ARTS-Laboratory/Ship-Structure-and-Fatigue-Environment-Ship-SAFE-testbed/README.md

# Ship Structure and Fatigue Environment (Ship SAFE) testbed
A tested for integrated ship structural and fatigue testing

<p align="center">
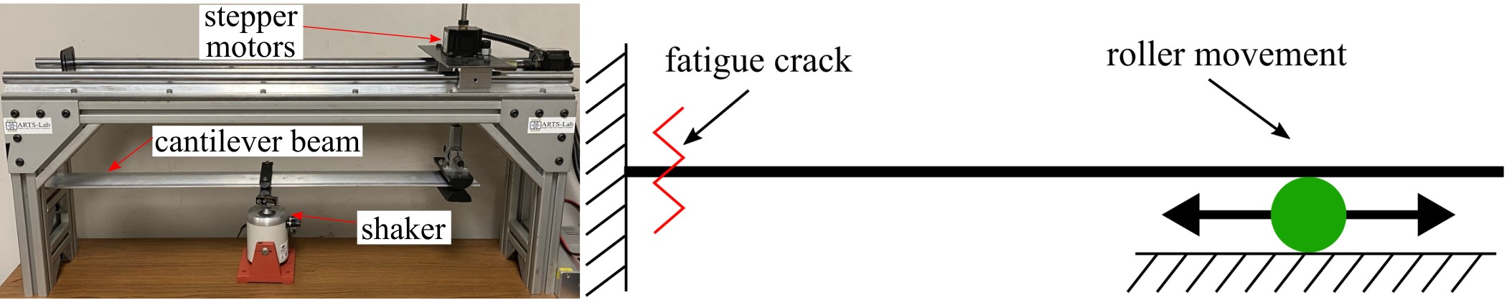
[picture p1: media/testbed.jpg]

</p>
<p align="center">
The Ship Structure and Fatigue Environment (Ship SAFE) testbed develoepd at the UofSC
</p>

## [Testbed](testbed)
CAD and FEA models of the testbed.

## Licensing and Citation

[][cc-by-sa]

This work is licensed under a
[Creative Commons Attribution-ShareAlike 4.0 International License][cc-by-sa].

[cc-by-sa]: http://creativecommons.org/licenses/by-sa/4.0/
[cc-by-sa-image]: https://licensebuttons.net/l/by-sa/4.0/88x31.png
[cc-by-sa-shield]: https://img.shields.io/badge/License-CC%20BY--SA%204.0-lightgrey.svg
