ARTS-Laboratory/Ship-Structure-and-Fatigue-Environment-Ship-SAFE-testbed/testbed/CAD/16_mm_Rail/16 mm SUPPORT RAIL v3.step

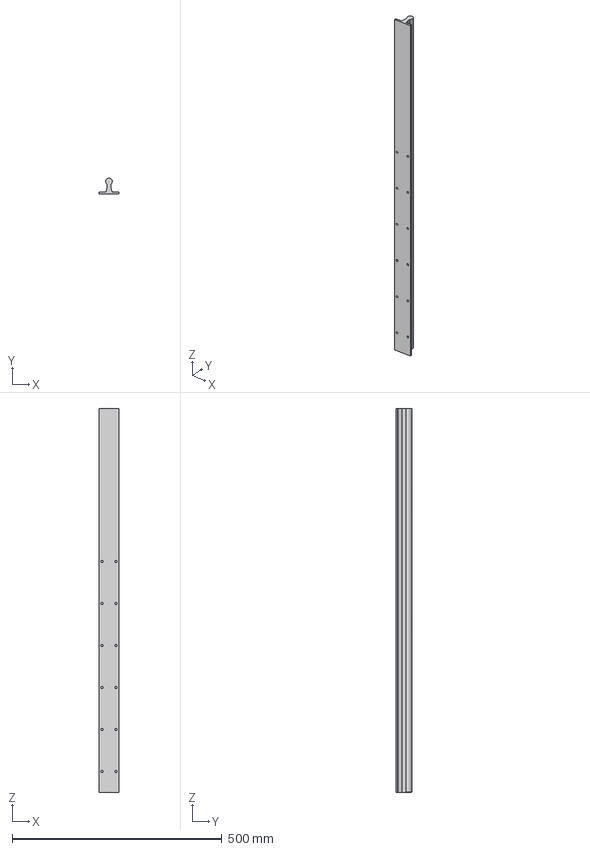
[picture p2: CAD file, 2022-03-26]
testbed/CAD/16_mm_Rail/16 mm SUPPORT RAIL v3.step
48.0 x 38.0 x 914.4 mm
