ARTS-Laboratory/Ship-Structure-and-Fatigue-Environment-Ship-SAFE-testbed/testbed/CAD/16_mm_Rail_Plate/16 mm Rail Plate v3.step

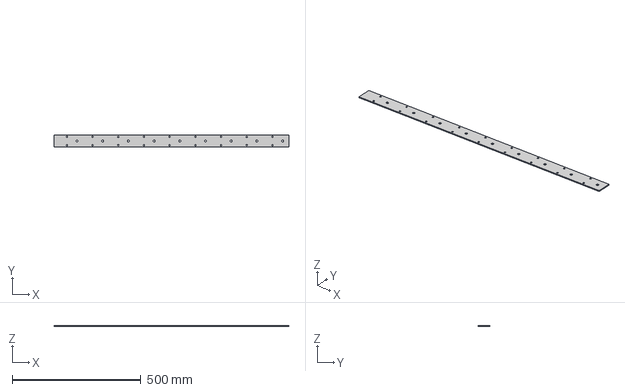
[picture p3: CAD file, 2022-03-26]
testbed/CAD/16_mm_Rail_Plate/16 mm Rail Plate v3.step
914.4 x 48.0 x 3.17 mm
