ARTS-Laboratory/Ship-Structure-and-Fatigue-Environment-Ship-SAFE-testbed/testbed/CAD/16_mm_Rail_Support/16 mm rail support TBR16UU v1.step

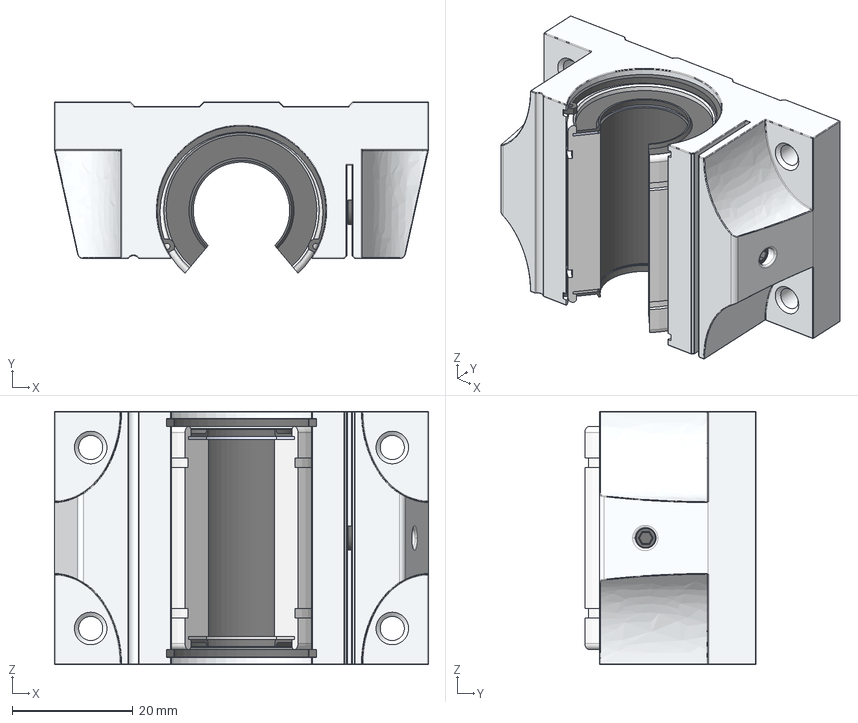
[picture p4: CAD file, 2022-03-26]
testbed/CAD/16_mm_Rail_Support/16 mm rail support TBR16UU v1.step
62.0 x 28.4 x 42.0 mm
TBR16UU
LM16UUOP
