ARTS-Laboratory/Ship-Structure-and-Fatigue-Environment-Ship-SAFE-testbed/testbed/CAD/40X40_12_in/40mm X 40mm 12 in v1.step

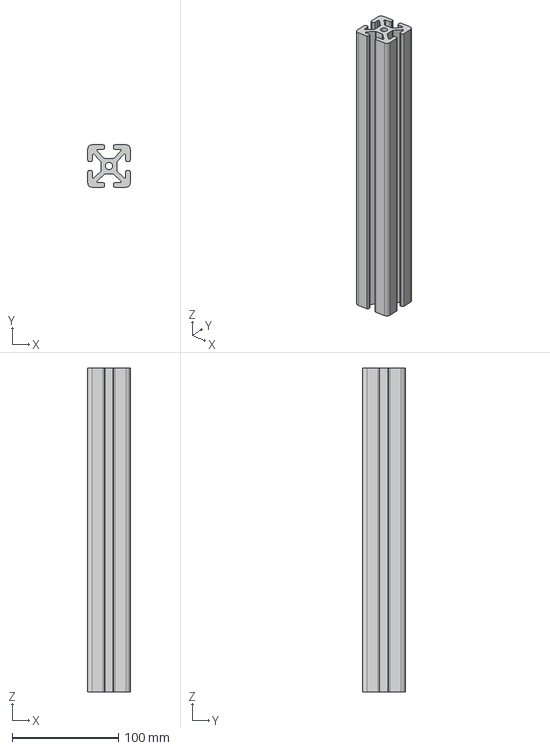
[picture p5: CAD file, 2022-03-26]
testbed/CAD/40X40_12_in/40mm X 40mm 12 in v1.step
40.0 x 40.0 x 304.8 mm
