ARTS-Laboratory/Ship-Structure-and-Fatigue-Environment-Ship-SAFE-testbed/testbed/CAD/40X40_3_ft/40mm X 40mm 3ft v2.step

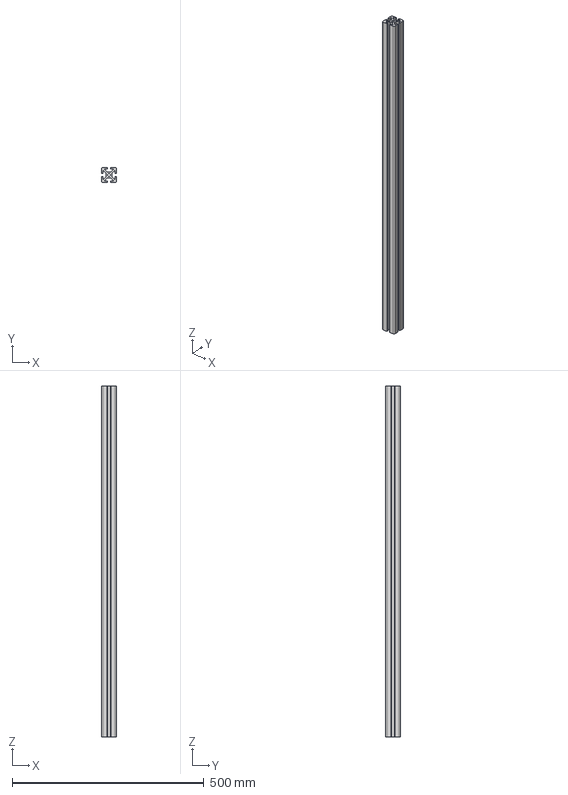
[picture p6: CAD file, 2022-03-26]
testbed/CAD/40X40_3_ft/40mm X 40mm 3ft v2.step
40.0 x 40.0 x 914.4 mm
