ARTS-Laboratory/Ship-Structure-and-Fatigue-Environment-Ship-SAFE-testbed/testbed/CAD/40X40_45_Degree/40mm X 40mm 45 Degree v1.step

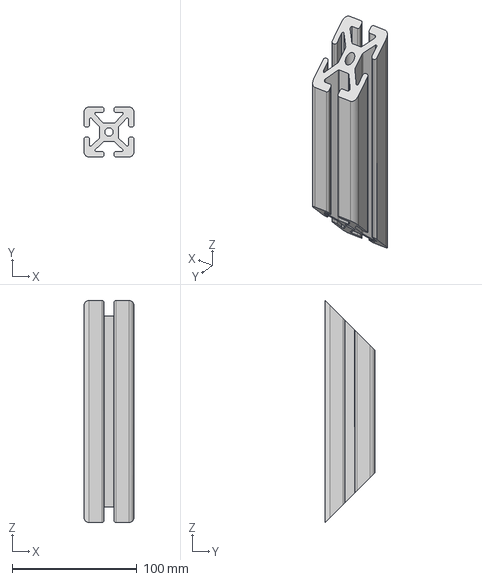
[picture p7: CAD file, 2022-03-26]
testbed/CAD/40X40_45_Degree/40mm X 40mm 45 Degree v1.step
40.0 x 40.0 x 177.8 mm
