ARTS-Laboratory/Ship-Structure-and-Fatigue-Environment-Ship-SAFE-testbed/testbed/CAD/40X40_97.8_mm/40mm X 40mm 97.8 mm v1.step

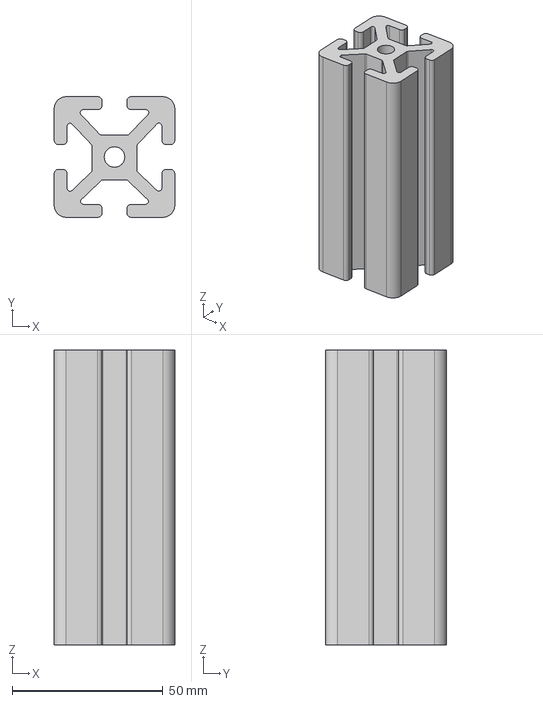
[picture p8: CAD file, 2022-03-26]
testbed/CAD/40X40_97.8_mm/40mm X 40mm 97.8 mm v1.step
40.0 x 40.0 x 97.8 mm
