ARTS-Laboratory/Ship-Structure-and-Fatigue-Environment-Ship-SAFE-testbed/testbed/CAD/Boat_Hull/Boat Hull v4.step

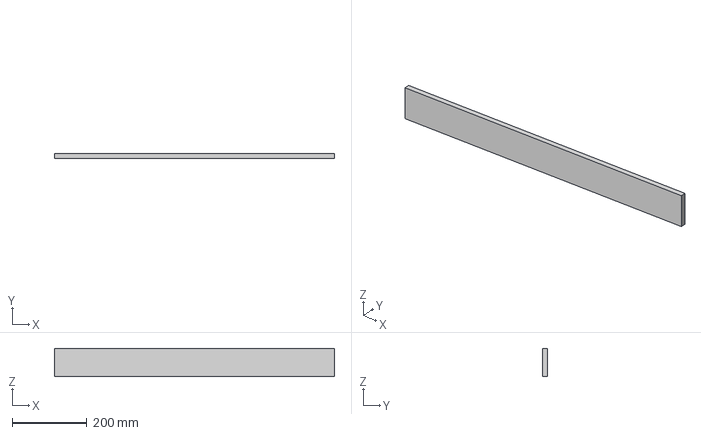
[picture p10: CAD file, 2022-03-26]
testbed/CAD/Boat_Hull/Boat Hull v4.step
750.0 x 12.7 x 76.2 mm
