ARTS-Laboratory/Ship-Structure-and-Fatigue-Environment-Ship-SAFE-testbed/testbed/CAD/Metric_Ball_Joint/METRIC BALL JOINT v1.step

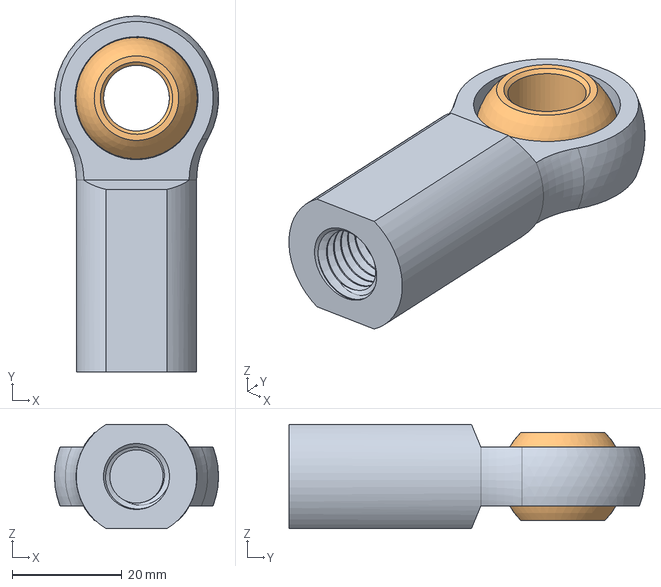
[picture p11: CAD file, 2022-03-26]
testbed/CAD/Metric_Ball_Joint/METRIC BALL JOINT v1.step
30.0 x 65.0 x 19.0 mm
