ARTS-Laboratory/Ship-Structure-and-Fatigue-Environment-Ship-SAFE-testbed/testbed/CAD/Shaker/Shaker v1.step

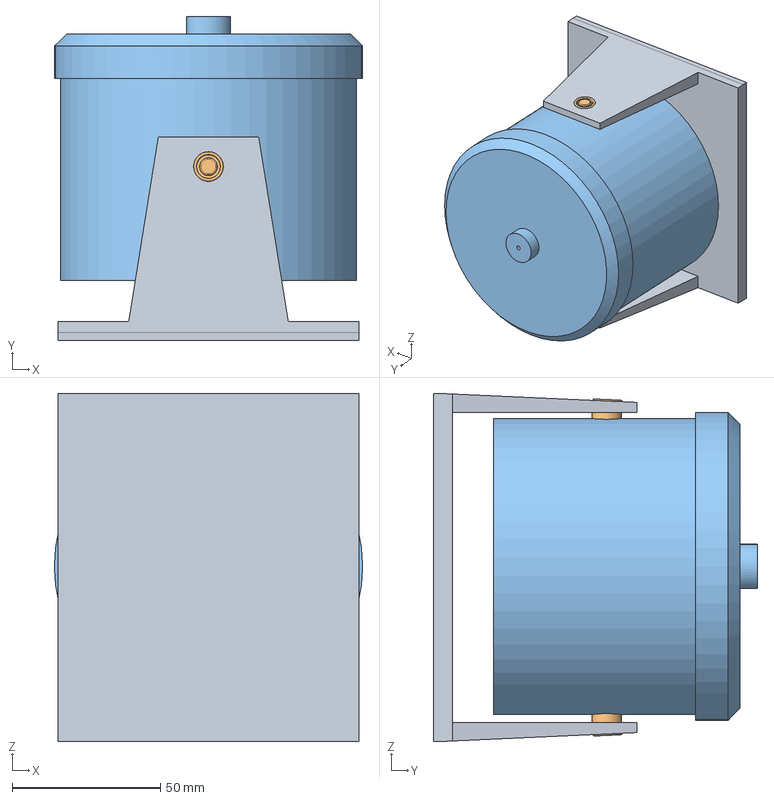
[picture p12: CAD file, 2022-03-26]
testbed/CAD/Shaker/Shaker v1.step
104.0 x 109.3 x 117.4 mm
Actual Shaker Stand
Shacker Pin Small x 2
