ARTS-Laboratory/Ship-Structure-and-Fatigue-Environment-Ship-SAFE-testbed/testbed/CAD/Shaker_Fixture/Shaker Fixture v1.step

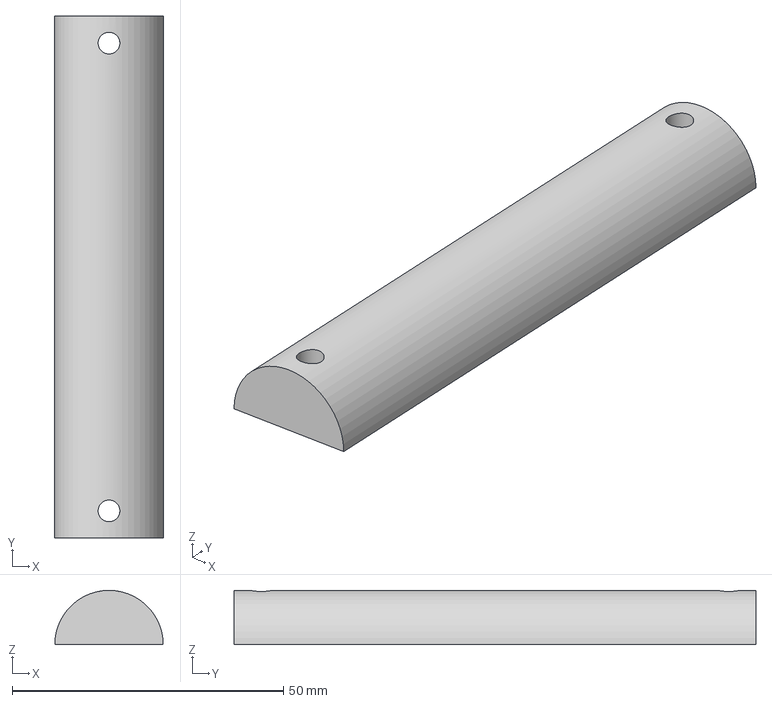
[picture p13: CAD file, 2022-03-26]
testbed/CAD/Shaker_Fixture/Shaker Fixture v1.step
20.0 x 96.2 x 10.0 mm
