ARTS-Laboratory/Ship-Structure-and-Fatigue-Environment-Ship-SAFE-testbed/testbed/CAD/SK_12_mm/SK 12mm v1.step

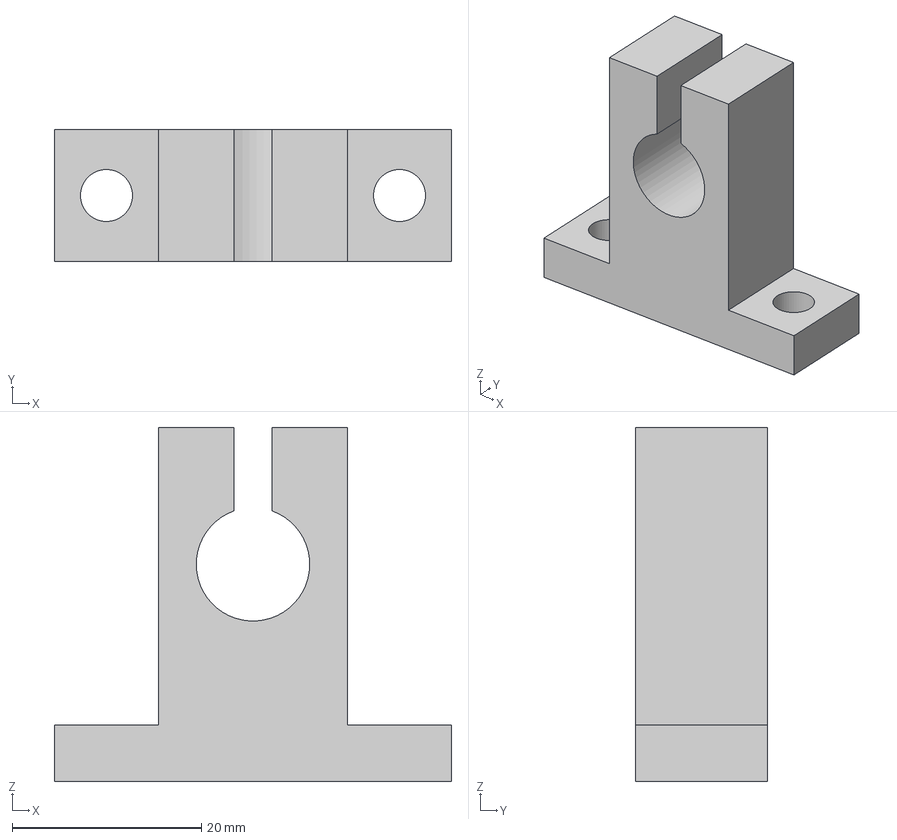
[picture p14: CAD file, 2022-03-26]
testbed/CAD/SK_12_mm/SK 12mm v1.step
42.0 x 14.0 x 37.5 mm
