ARTS-Laboratory/Ship-Structure-and-Fatigue-Environment-Ship-SAFE-testbed/testbed/CAD/Stepper_Fixture/Stepper Fixture v1.step

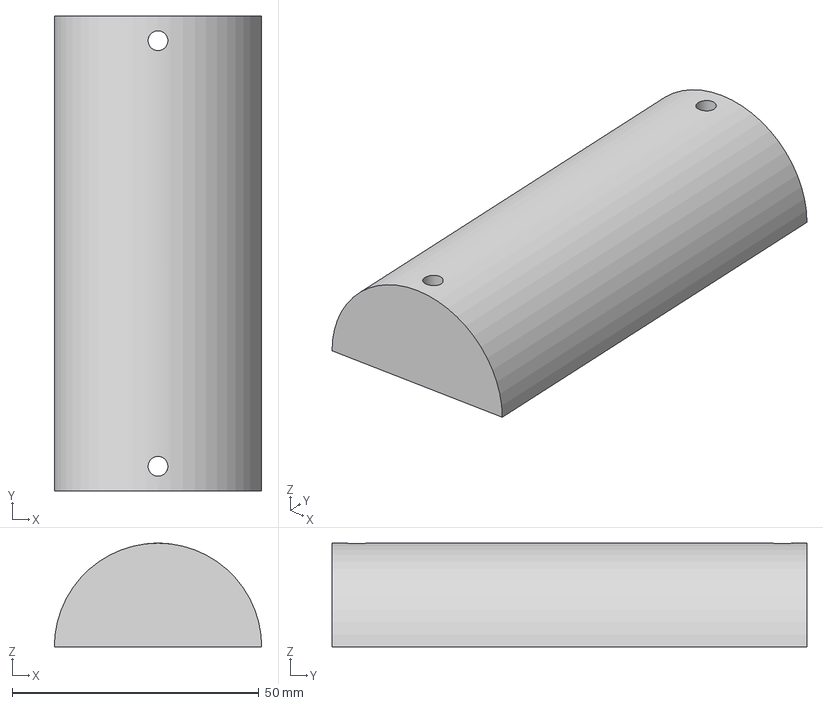
[picture p15: CAD file, 2022-03-26]
testbed/CAD/Stepper_Fixture/Stepper Fixture v1.step
42.0 x 96.2 x 21.0 mm
