ARTS-Laboratory/Ship-Structure-and-Fatigue-Environment-Ship-SAFE-testbed/testbed/CAD/Stepper_Through_Hole/Stepper Motor Through Hole v1.step

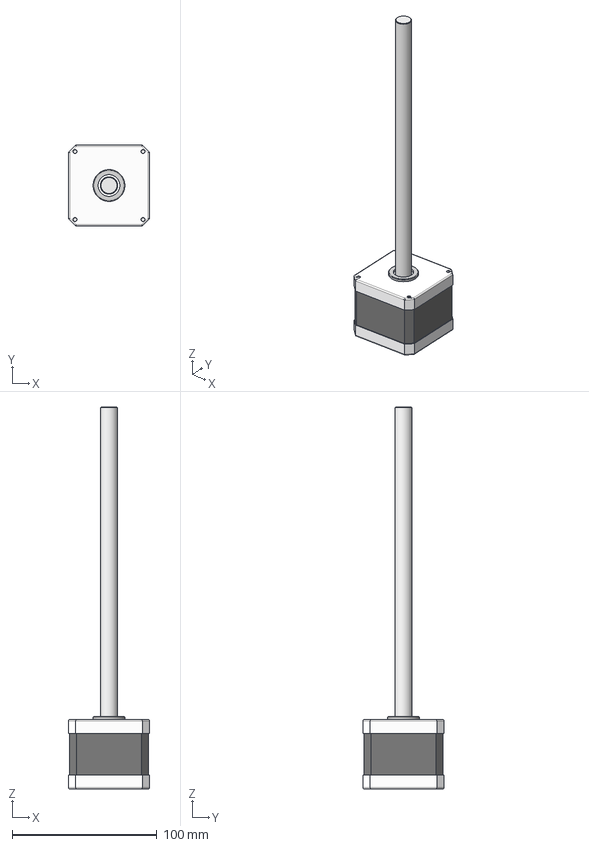
[picture p17: CAD file, 2022-03-26]
testbed/CAD/Stepper_Through_Hole/Stepper Motor Through Hole v1.step
56.0 x 56.0 x 263.9 mm
