ARTS-Laboratory/Ship-Structure-and-Fatigue-Environment-Ship-SAFE-testbed/testbed/CAD/Stepper_Through_Hole_Offset/Stepper Motor Through Hole offset v1.step

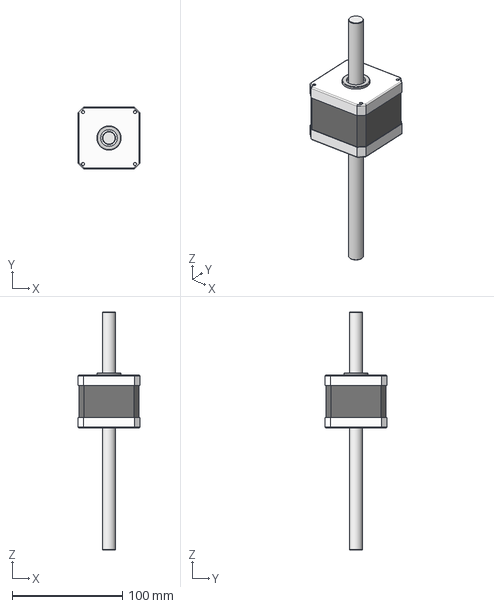
[picture p18: CAD file, 2022-03-26]
testbed/CAD/Stepper_Through_Hole_Offset/Stepper Motor Through Hole offset v1.step
56.0 x 56.0 x 215.9 mm
