ARTS-Laboratory/Ship-Structure-and-Fatigue-Environment-Ship-SAFE-testbed/testbed/CAD/Eye_Bolt/Eye Bolt v1.step

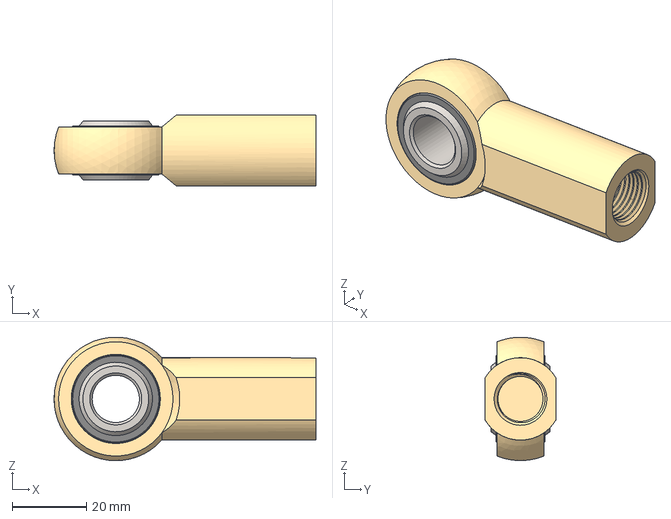
[picture p19: CAD file, 2022-03-26]
testbed/CAD/Eye_Bolt/Eye Bolt v1.step
70.6 x 19.0 x 33.3 mm
