ARTS-Laboratory/Ship-Structure-and-Fatigue-Environment-Ship-SAFE-testbed/(list of files, cad)

Other CAD files:
testbed/CAD/16_mm_Rail/16 mm SUPPORT RAIL v3.3mf
testbed/CAD/16_mm_Rail/16 mm SUPPORT RAIL v3.dwg
testbed/CAD/16_mm_Rail/16 mm SUPPORT RAIL v3.dxf
testbed/CAD/16_mm_Rail/16 mm SUPPORT RAIL v3.f3d
testbed/CAD/16_mm_Rail/16 mm SUPPORT RAIL v3.iges
testbed/CAD/16_mm_Rail/16 mm SUPPORT RAIL v3.ipt
testbed/CAD/16_mm_Rail/16 mm SUPPORT RAIL v3.obj
testbed/CAD/16_mm_Rail/16 mm SUPPORT RAIL v3.skp
testbed/CAD/16_mm_Rail/16 mm SUPPORT RAIL v3.stl
testbed/CAD/16_mm_Rail_Plate/16 mm Rail Plate v3.3mf
testbed/CAD/16_mm_Rail_Plate/16 mm Rail Plate v3.dwg
testbed/CAD/16_mm_Rail_Plate/16 mm Rail Plate v3.dxf
testbed/CAD/16_mm_Rail_Plate/16 mm Rail Plate v3.f3d
testbed/CAD/16_mm_Rail_Plate/16 mm Rail Plate v3.iges
testbed/CAD/16_mm_Rail_Plate/16 mm Rail Plate v3.ipt
testbed/CAD/16_mm_Rail_Plate/16 mm Rail Plate v3.obj
testbed/CAD/16_mm_Rail_Plate/16 mm Rail Plate v3.skp
testbed/CAD/16_mm_Rail_Plate/16 mm Rail Plate v3.stl
testbed/CAD/16_mm_Rail_Support/16 mm rail support TBR16UU v1.3mf
testbed/CAD/16_mm_Rail_Support/16 mm rail support TBR16UU v1.dwg
testbed/CAD/16_mm_Rail_Support/16 mm rail support TBR16UU v1.dxf
testbed/CAD/16_mm_Rail_Support/16 mm rail support TBR16UU v1.f3d
testbed/CAD/16_mm_Rail_Support/16 mm rail support TBR16UU v1.iges
testbed/CAD/16_mm_Rail_Support/16 mm rail support TBR16UU v1.obj
testbed/CAD/16_mm_Rail_Support/16 mm rail support TBR16UU v1.skp
testbed/CAD/16_mm_Rail_Support/16 mm rail support TBR16UU v1.stl
testbed/CAD/40X40_12_in/40mm X 40mm 12 in v1.3mf
testbed/CAD/40X40_12_in/40mm X 40mm 12 in v1.dwg
testbed/CAD/40X40_12_in/40mm X 40mm 12 in v1.dxf
testbed/CAD/40X40_12_in/40mm X 40mm 12 in v1.f3d
testbed/CAD/40X40_12_in/40mm X 40mm 12 in v1.iges
testbed/CAD/40X40_12_in/40mm X 40mm 12 in v1.ipt
testbed/CAD/40X40_12_in/40mm X 40mm 12 in v1.obj
testbed/CAD/40X40_12_in/40mm X 40mm 12 in v1.skp
testbed/CAD/40X40_12_in/40mm X 40mm 12 in v1.stl
testbed/CAD/40X40_3_ft/40mm X 40mm 3ft v2.3mf
testbed/CAD/40X40_3_ft/40mm X 40mm 3ft v2.dwg
testbed/CAD/40X40_3_ft/40mm X 40mm 3ft v2.dxf
testbed/CAD/40X40_3_ft/40mm X 40mm 3ft v2.f3d
testbed/CAD/40X40_3_ft/40mm X 40mm 3ft v2.iges
testbed/CAD/40X40_3_ft/40mm X 40mm 3ft v2.ipt
testbed/CAD/40X40_3_ft/40mm X 40mm 3ft v2.obj
testbed/CAD/40X40_3_ft/40mm X 40mm 3ft v2.skp
testbed/CAD/40X40_3_ft/40mm X 40mm 3ft v2.stl
testbed/CAD/40X40_45_Degree/40mm X 40mm 45 Degree v1.3mf
testbed/CAD/40X40_45_Degree/40mm X 40mm 45 Degree v1.dwg
testbed/CAD/40X40_45_Degree/40mm X 40mm 45 Degree v1.dxf
testbed/CAD/40X40_45_Degree/40mm X 40mm 45 Degree v1.f3d
testbed/CAD/40X40_45_Degree/40mm X 40mm 45 Degree v1.iges
testbed/CAD/40X40_45_Degree/40mm X 40mm 45 Degree v1.ipt
testbed/CAD/40X40_45_Degree/40mm X 40mm 45 Degree v1.obj
testbed/CAD/40X40_45_Degree/40mm X 40mm 45 Degree v1.skp
testbed/CAD/40X40_45_Degree/40mm X 40mm 45 Degree v1.stl
testbed/CAD/40X40_97.8_mm/40mm X 40mm 97.8 mm v1.3mf
testbed/CAD/40X40_97.8_mm/40mm X 40mm 97.8 mm v1.dwg
testbed/CAD/40X40_97.8_mm/40mm X 40mm 97.8 mm v1.dxf
testbed/CAD/40X40_97.8_mm/40mm X 40mm 97.8 mm v1.f3d
testbed/CAD/40X40_97.8_mm/40mm X 40mm 97.8 mm v1.iges
testbed/CAD/40X40_97.8_mm/40mm X 40mm 97.8 mm v1.ipt
testbed/CAD/40X40_97.8_mm/40mm X 40mm 97.8 mm v1.obj
testbed/CAD/40X40_97.8_mm/40mm X 40mm 97.8 mm v1.skp
testbed/CAD/40X40_97.8_mm/40mm X 40mm 97.8 mm v1.stl
testbed/CAD/Assembled_Testbed/Navy 40 X 40 Stepper Box v8.f3z
testbed/CAD/Assembled_Testbed/Navy 40 X 40 Stepper Box v9.dwg
testbed/CAD/Boat_Hull/Boat Hull v4.3mf
testbed/CAD/Boat_Hull/Boat Hull v4.dwg
testbed/CAD/Boat_Hull/Boat Hull v4.dxf
testbed/CAD/Boat_Hull/Boat Hull v4.f3d
testbed/CAD/Boat_Hull/Boat Hull v4.iges
testbed/CAD/Boat_Hull/Boat Hull v4.ipt
testbed/CAD/Boat_Hull/Boat Hull v4.obj
testbed/CAD/Boat_Hull/Boat Hull v4.skp
testbed/CAD/Boat_Hull/Boat Hull v4.stl
testbed/CAD/Eye_Bolt/Eye Bolt v1.3mf
testbed/CAD/Eye_Bolt/Eye Bolt v1.dwg
testbed/CAD/Eye_Bolt/Eye Bolt v1.dxf
testbed/CAD/Eye_Bolt/Eye Bolt v1.f3d
testbed/CAD/Eye_Bolt/Eye Bolt v1.iges
testbed/CAD/Eye_Bolt/Eye Bolt v1.ipt
testbed/CAD/Eye_Bolt/Eye Bolt v1.obj
testbed/CAD/Eye_Bolt/Eye Bolt v1.skp
testbed/CAD/Eye_Bolt/Eye Bolt v1.stl
testbed/CAD/Eye_Bolt_Screw/Eye Bolt Screw v1.3mf
testbed/CAD/Eye_Bolt_Screw/Eye Bolt Screw v1.dwg
testbed/CAD/Eye_Bolt_Screw/Eye Bolt Screw v1.f3d
testbed/CAD/Eye_Bolt_Screw/Eye Bolt Screw v1.ipt
testbed/CAD/Eye_Bolt_Screw/Eye Bolt Screw v1.obj
testbed/CAD/Eye_Bolt_Screw/Eye Bolt Screw v1.skp
testbed/CAD/Eye_Bolt_Screw/Eye Bolt Screw v1.stl
testbed/CAD/Metric_Ball_Joint/METRIC BALL JOINT v1.3mf
testbed/CAD/Metric_Ball_Joint/METRIC BALL JOINT v1.dwg
testbed/CAD/Metric_Ball_Joint/METRIC BALL JOINT v1.dxf
testbed/CAD/Metric_Ball_Joint/METRIC BALL JOINT v1.f3d
testbed/CAD/Metric_Ball_Joint/METRIC BALL JOINT v1.iges
testbed/CAD/Metric_Ball_Joint/METRIC BALL JOINT v1.ipt
testbed/CAD/Metric_Ball_Joint/METRIC BALL JOINT v1.obj
testbed/CAD/Metric_Ball_Joint/METRIC BALL JOINT v1.skp
testbed/CAD/Metric_Ball_Joint/METRIC BALL JOINT v1.stl
testbed/CAD/SK_12_mm/SK 12mm v1.3mf
testbed/CAD/SK_12_mm/SK 12mm v1.dwg
testbed/CAD/SK_12_mm/SK 12mm v1.dxf
testbed/CAD/SK_12_mm/SK 12mm v1.f3d
testbed/CAD/SK_12_mm/SK 12mm v1.iges
testbed/CAD/SK_12_mm/SK 12mm v1.ipt
testbed/CAD/SK_12_mm/SK 12mm v1.obj
testbed/CAD/SK_12_mm/SK 12mm v1.skp
testbed/CAD/SK_12_mm/SK 12mm v1.stl
testbed/CAD/Shaker/Shaker v1.3mf
testbed/CAD/Shaker/Shaker v1.dwg
testbed/CAD/Shaker/Shaker v1.dxf
testbed/CAD/Shaker/Shaker v1.f3z
testbed/CAD/Shaker/Shaker v1.iges
testbed/CAD/Shaker/Shaker v1.obj
testbed/CAD/Shaker/Shaker v1.skp
testbed/CAD/Shaker/Shaker v1.stl
testbed/CAD/Shaker_Fixture/Shaker Fixture v1.3mf
testbed/CAD/Shaker_Fixture/Shaker Fixture v1.dwg
testbed/CAD/Shaker_Fixture/Shaker Fixture v1.dxf
testbed/CAD/Shaker_Fixture/Shaker Fixture v1.f3d
testbed/CAD/Shaker_Fixture/Shaker Fixture v1.iges
testbed/CAD/Shaker_Fixture/Shaker Fixture v1.ipt
testbed/CAD/Shaker_Fixture/Shaker Fixture v1.obj
testbed/CAD/Shaker_Fixture/Shaker Fixture v1.skp
testbed/CAD/Shaker_Fixture/Shaker Fixture v1.stl
testbed/CAD/Stepper_Fixture/Stepper Fixture v1.3mf
testbed/CAD/Stepper_Fixture/Stepper Fixture v1.dwg
testbed/CAD/Stepper_Fixture/Stepper Fixture v1.dxf
testbed/CAD/Stepper_Fixture/Stepper Fixture v1.f3d
testbed/CAD/Stepper_Fixture/Stepper Fixture v1.iges
testbed/CAD/Stepper_Fixture/Stepper Fixture v1.ipt
testbed/CAD/Stepper_Fixture/Stepper Fixture v1.obj
testbed/CAD/Stepper_Fixture/Stepper Fixture v1.skp
testbed/CAD/Stepper_Fixture/Stepper Fixture v1.stl
testbed/CAD/Stepper_Plate/Stepper Plate v6.3mf
testbed/CAD/Stepper_Plate/Stepper Plate v6.dwg
testbed/CAD/Stepper_Plate/Stepper Plate v6.dxf
testbed/CAD/Stepper_Plate/Stepper Plate v6.f3d
testbed/CAD/Stepper_Plate/Stepper Plate v6.iges
testbed/CAD/Stepper_Plate/Stepper Plate v6.ipt
testbed/CAD/Stepper_Plate/Stepper Plate v6.obj
testbed/CAD/Stepper_Plate/Stepper Plate v6.skp
testbed/CAD/Stepper_Plate/Stepper Plate v6.stl
testbed/CAD/Stepper_Through_Hole/Stepper Motor Through Hole v1.3mf
testbed/CAD/Stepper_Through_Hole/Stepper Motor Through Hole v1.dwg
testbed/CAD/Stepper_Through_Hole/Stepper Motor Through Hole v1.dxf
testbed/CAD/Stepper_Through_Hole/Stepper Motor Through Hole v1.f3d
testbed/CAD/Stepper_Through_Hole/Stepper Motor Through Hole v1.iges
testbed/CAD/Stepper_Through_Hole/Stepper Motor Through Hole v1.ipt
testbed/CAD/Stepper_Through_Hole/Stepper Motor Through Hole v1.obj
testbed/CAD/Stepper_Through_Hole/Stepper Motor Through Hole v1.skp
testbed/CAD/Stepper_Through_Hole/Stepper Motor Through Hole v1.stl
testbed/CAD/Stepper_Through_Hole_Offset/Stepper Motor Through Hole offset v1.3mf
testbed/CAD/Stepper_Through_Hole_Offset/Stepper Motor Through Hole offset v1.dwg
testbed/CAD/Stepper_Through_Hole_Offset/Stepper Motor Through Hole offset v1.dxf
testbed/CAD/Stepper_Through_Hole_Offset/Stepper Motor Through Hole offset v1.f3d
testbed/CAD/Stepper_Through_Hole_Offset/Stepper Motor Through Hole offset v1.iges
testbed/CAD/Stepper_Through_Hole_Offset/Stepper Motor Through Hole offset v1.ipt
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
