ARTS-Laboratory/Ship-Structure-and-Fatigue-Environment-Ship-SAFE-testbed/testbed/README.md

# Testbed
A tested for integrated ship structural and fatigue testing

## [CAD](CAD)
1. CAD files for the test bed.
