ARTS-Laboratory/Ship-Structure-and-Fatigue-Environment-Ship-SAFE-testbed/testbed/FEA/Modes/Mode_1/Mode_1.png

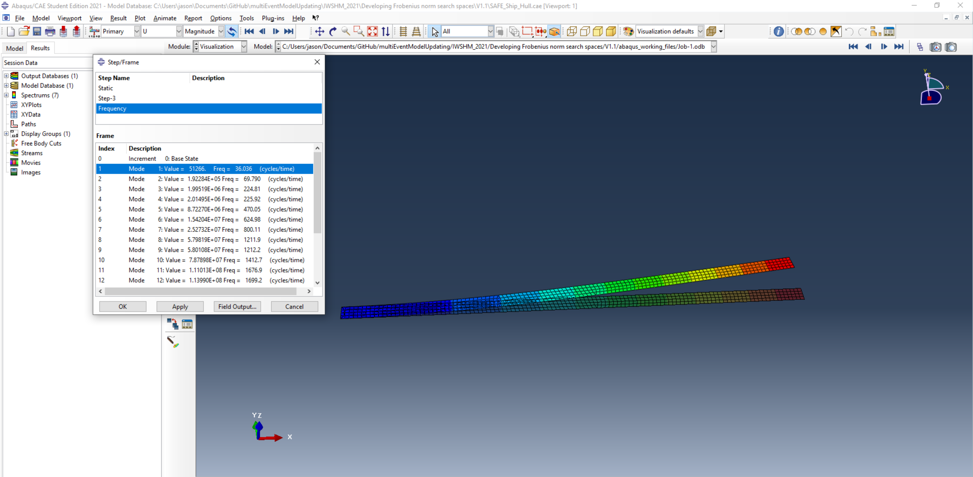
testbed/FEA/Modes/Mode_1/Mode_1.png
