ARTS-Laboratory/Ship-Structure-and-Fatigue-Environment-Ship-SAFE-testbed/testbed/FEA/Modes/Mode_2/Mode_2.png

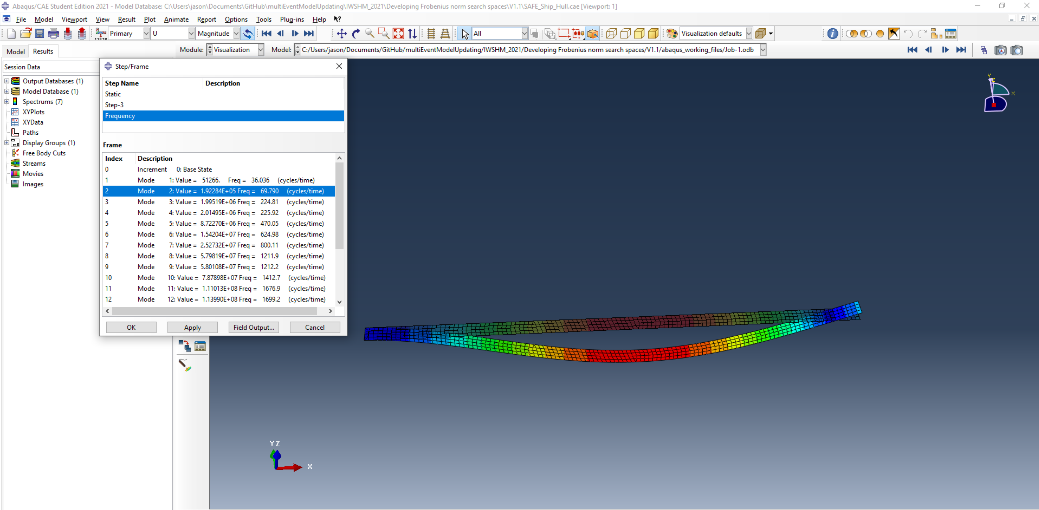
testbed/FEA/Modes/Mode_2/Mode_2.png
