ARTS-Laboratory/Ship-Structure-and-Fatigue-Environment-Ship-SAFE-testbed/testbed/FEA/Modes/Mode_3/Mode_3.png

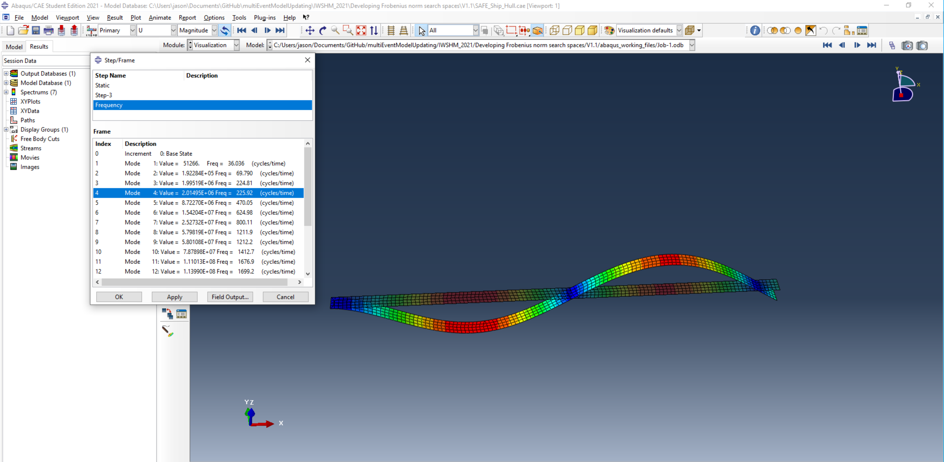
testbed/FEA/Modes/Mode_3/Mode_3.png
