ARTS-Laboratory/Ship-Structure-and-Fatigue-Environment-Ship-SAFE-testbed/testbed/FEA/Modes/Mode_4/Mode_4.png

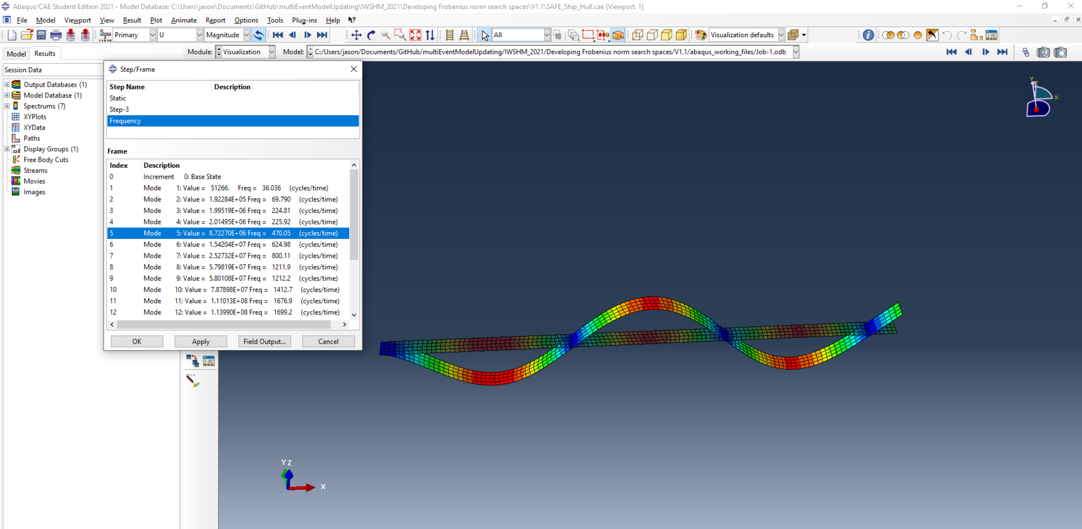
testbed/FEA/Modes/Mode_4/Mode_4.png
