ARTS-Laboratory/Ship-Structure-and-Fatigue-Environment-Ship-SAFE-testbed/testbed/FEA/Modes/Mode_5/Mode_5.png

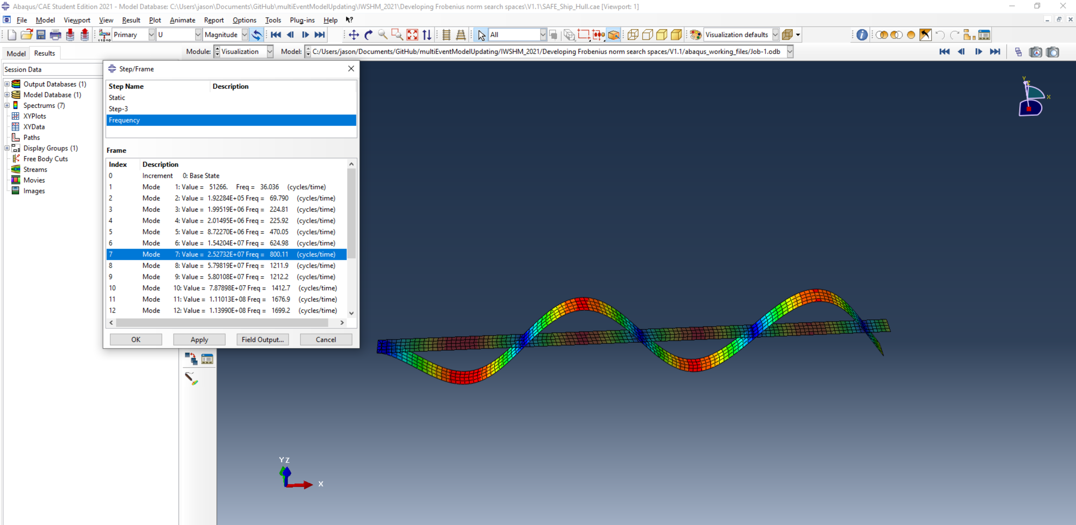
testbed/FEA/Modes/Mode_5/Mode_5.png
