ARTS-Laboratory/Ship-Structure-and-Fatigue-Environment-Ship-SAFE-testbed/testbed/Pictures/Physical_Test_Stand_Oganized_1.jpg

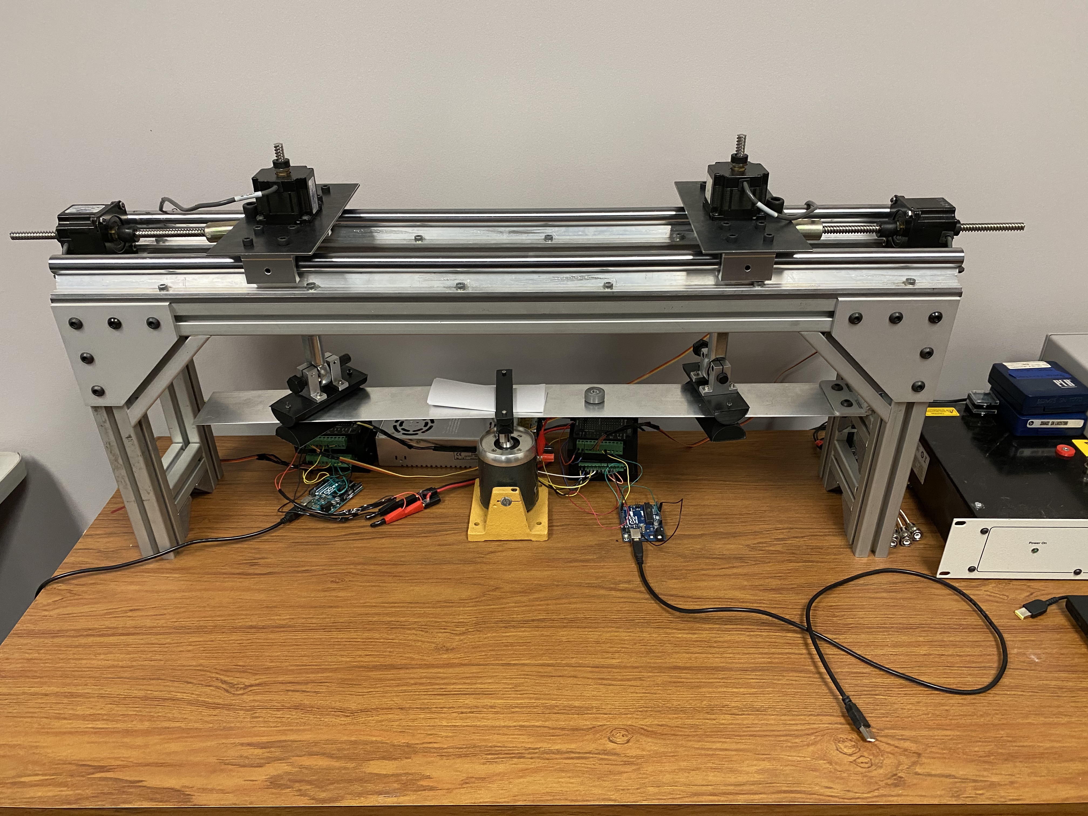
testbed/Pictures/Physical_Test_Stand_Oganized_1.jpg
