ARTS-Laboratory/Ship-Structure-and-Fatigue-Environment-Ship-SAFE-testbed/testbed/Pictures/Physical_Test_Stand_Organized_2.jpg

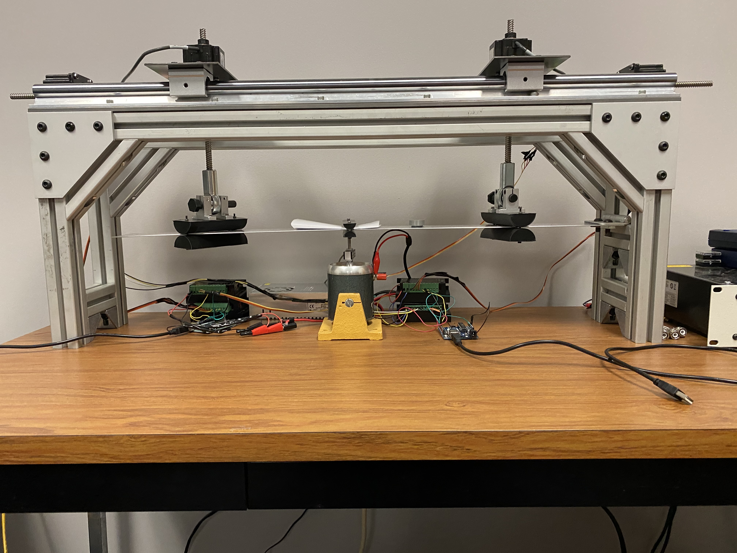
testbed/Pictures/Physical_Test_Stand_Organized_2.jpg
