ARTS-Laboratory/Ship-Structure-and-Fatigue-Environment-Ship-SAFE-testbed/(commit log)

2022-03-25 added cad files
    [Navy 40 X 40 Stepper Box v8.f3z, Navy 40 X 40 Stepper Box v9.dwg, Navy 40 X 40 Stepper Box v9.step]
2022-03-26 CAD files
    [16 mm Rail Plate v3.3mf, 16 mm Rail Plate v3.dwg, 16 mm Rail Plate v3.dxf, 16 mm Rail Plate v3.f3d, 16 mm Rail Plate v3.iges, 16 mm Rail Plate v3.ipt, 16 mm Rail Plate v3.obj, 16 mm Rail Plate v3.skp]
